dvernooy/ErgWare/docs/ErgWare_info_0.1.pdf

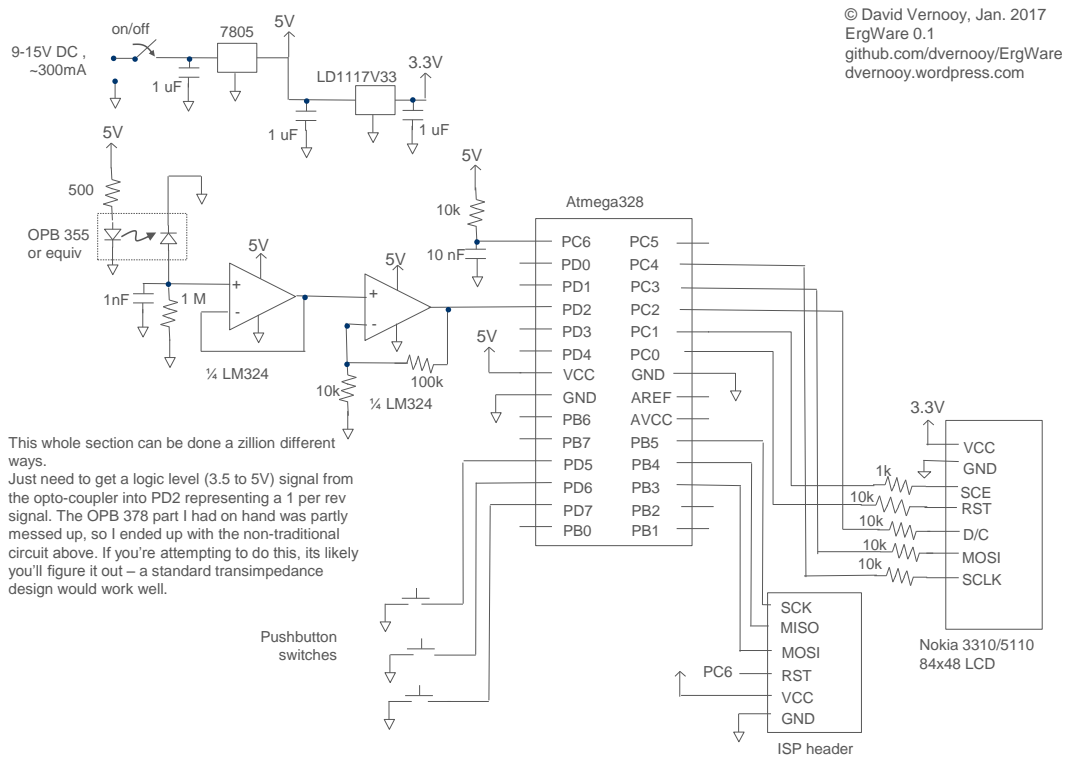
[picture p1: page 1]
Atmega328; PD4 VCC; GND; PC0 GND; AREF; AVCC; Nokia 3310/5110 84x48 LCD; ISP header; SCE RST; MOSI; SCLK; VCC GND; SCK MISO; RST; Pushbutton switches; OPB 355 or equiv; on/off

© David Vernooy, Jan. 2017
ErgWare 0.1
github.com/dvernooy/ErgWare
dvernooy.wordpress.com

This whole section can be done a zillion different
ways.
Just need to get a logic level (3.5 to 5V) signal from
the opto-coupler into PD2 representing a 1 per rev
signal. The OPB 378 part I had on hand was partly
messed up, so I ended up with the non-traditional
circuit above. If you’re attempting to do this, its likely
you’ll figure it out – a standard transimpedance
design would work well.

dvernooy.wordpress.com

Cut out this pattern, Glue or tape to a CD & attach concentric with wheel & slot into slot of optocoupler. Software currently assumes an 8-wedge pattern, but really a single spoke will work with a very minor change to code. I used an old mountain bike wheel and just attached this to where the disk brake would mount on the non-drive/non-cog side.

The OD of this template should fit a standard CD.

The ID should fit the bolt pattern of disk brake. You’ll have to drill a few holes on that radius to mount it & also cut out the center. I used a soldering iron to melt the cd plastic instead of trying to cut it.

You might have to take off the film on the CD to make it transparent, & of course cut away the white paper on this pattern where it goes through the optocoupler

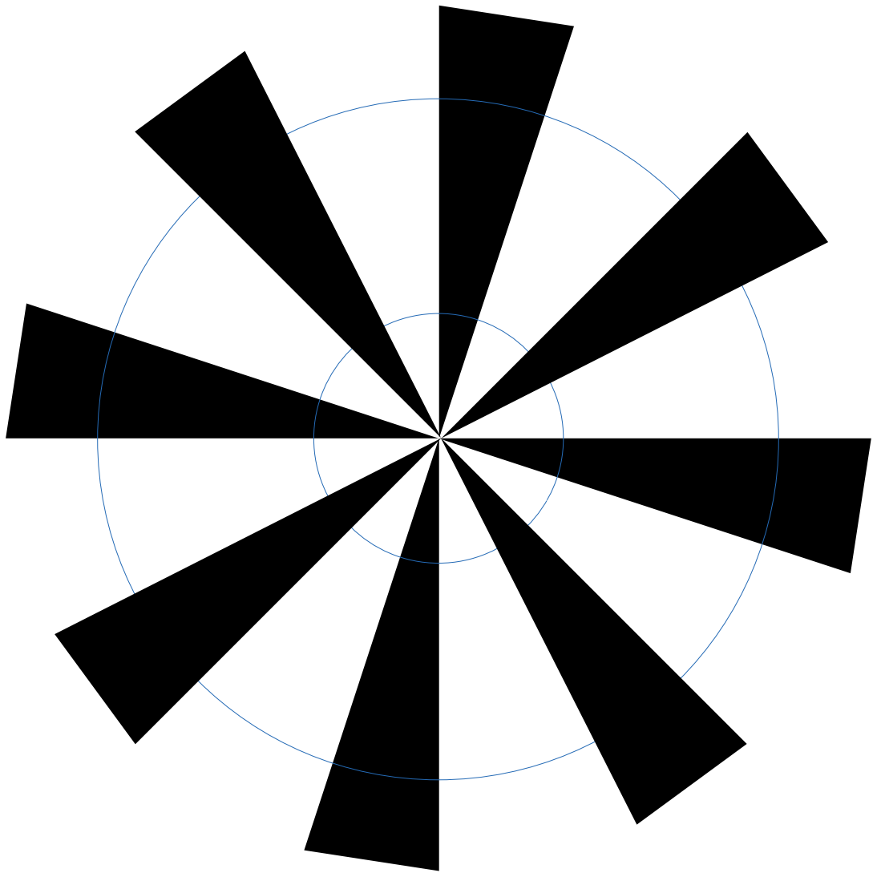
[picture p2: figure]

You could also buy a chopper wheel, use one out of an old optical mouse, or forget this method altogether and just use a reed switch like they typically do in bike computers. In those cases, you’ll probably need to modify the circuit and software.

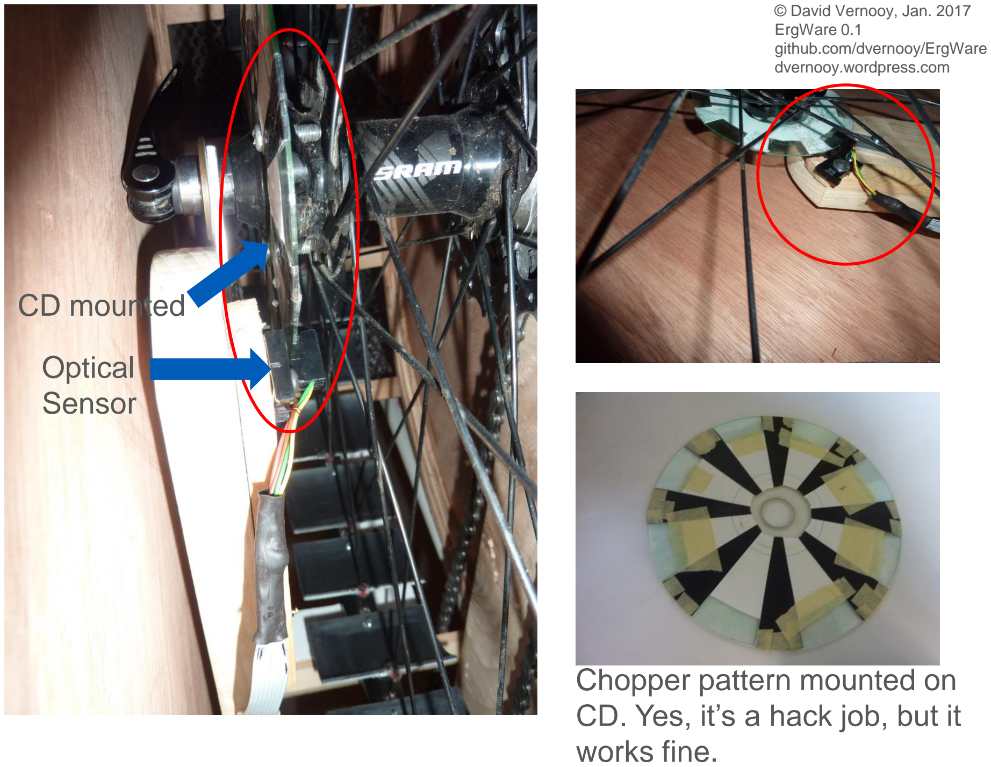
[picture p3: page 3]

dvernooy.wordpress.com

## Optical Sensor

## Chopper pattern mounted on CD. Yes, it’s a hack job, but it

works fine.

## CD mounted

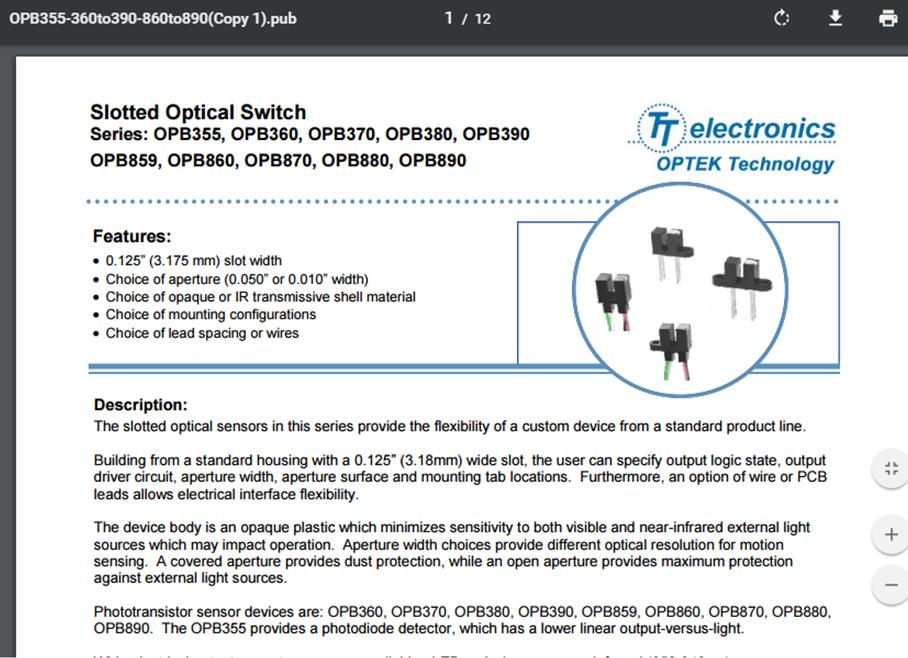
[picture p4: page 4]

dvernooy.wordpress.com

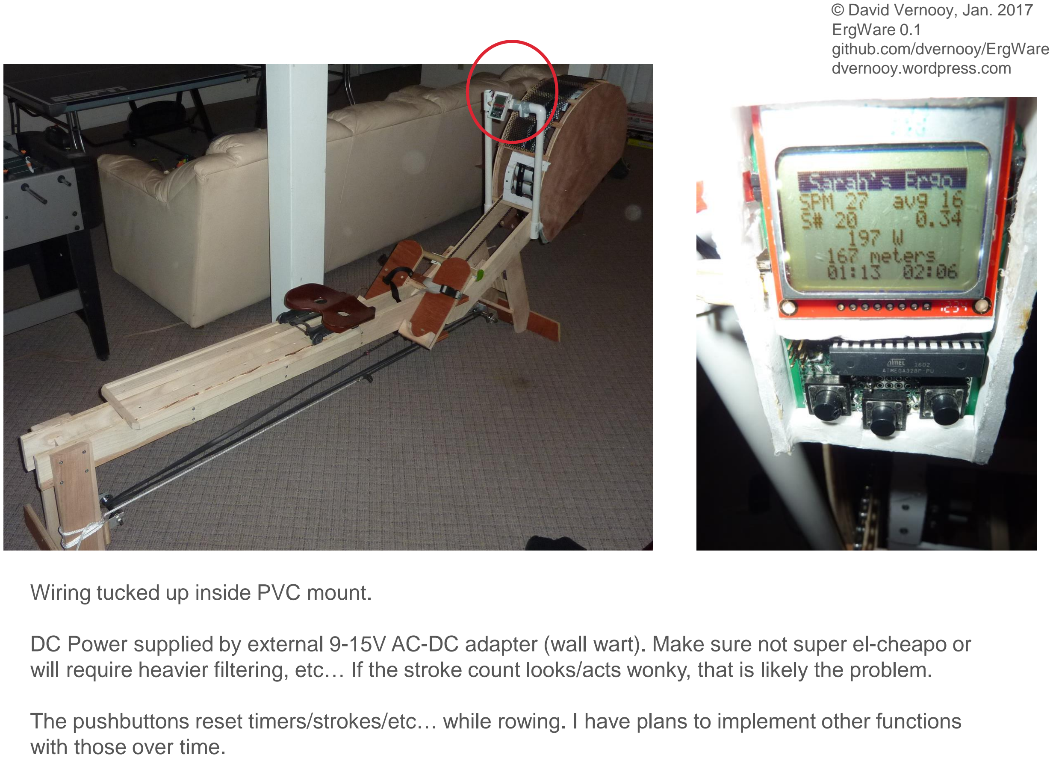
[picture p5: page 5]

dvernooy.wordpress.com

Wiring tucked up inside PVC mount.

DC Power supplied by external 9-15V AC-DC adapter (wall wart). Make sure not super el-cheapo or will require heavier filtering, etc… If the stroke count looks/acts wonky, that is likely the problem.

The pushbuttons reset timers/strokes/etc… while rowing. I have plans to implement other functions with those over time.

dvernooy.wordpress.com

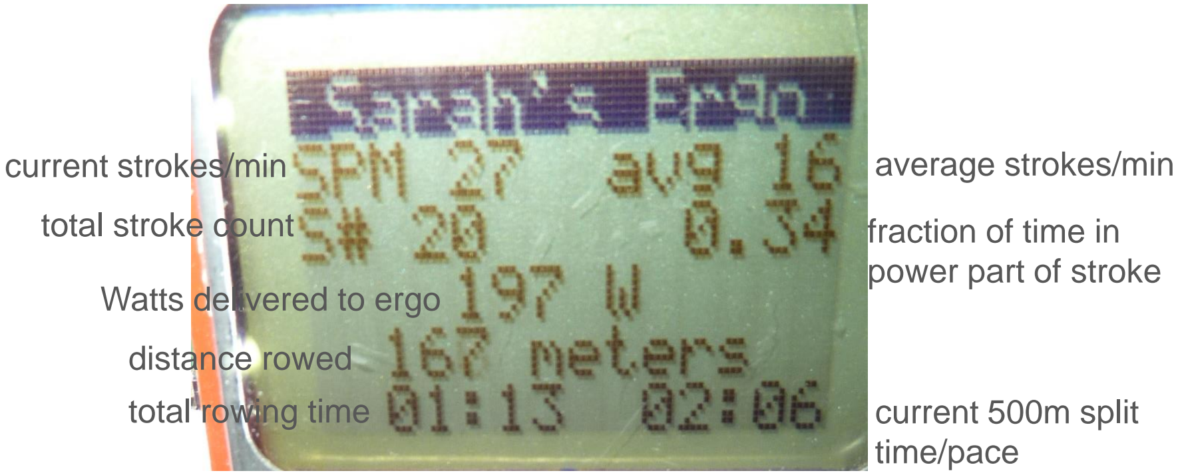
[picture p6: figure]
distance rowed; current strokes/min; average strokes/min; total stroke count; fraction of time in; power part of stroke; Watts delivered to ergo; total rowing time; current 500m split; time/pace
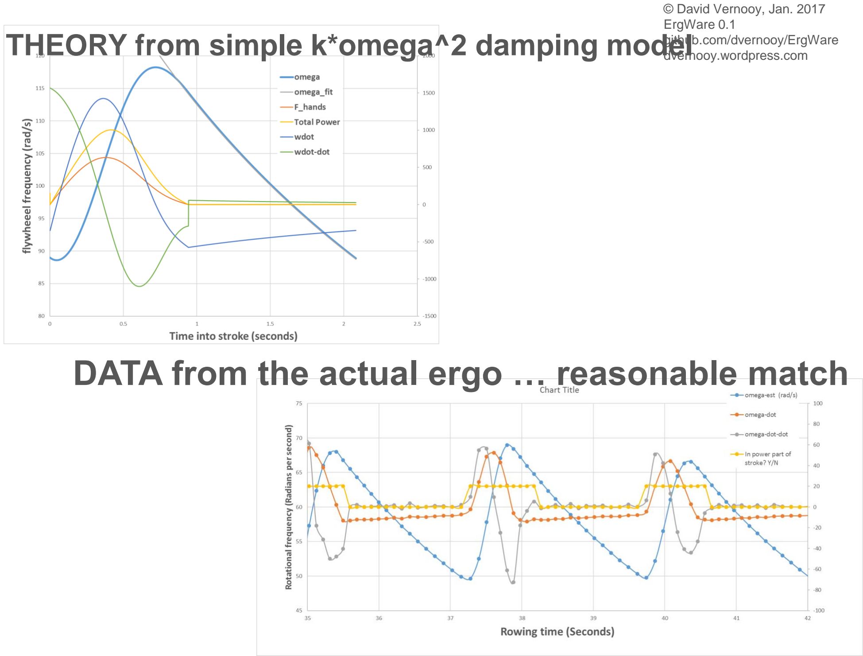
[picture p7: page 7]

github.com/dvernooy/ErgWare THEORY from simple k*omega^2 damping model dvernooy.wordpress.com

# DATA from the actual ergo … reasonable match

dvernooy.wordpress.com

## Good references:

## http://eodg.atm.ox.ac.uk/user/dudhia/rowing/physics/ergometer.html#section9 … for the origin of the factor 2.8 in the code

## http://home.hccnet.nl/m.holst/ErgoDisp.pdf ... Makes me think that at some point displaying energy (calories) burned might be interesting

## http://home.hccnet.nl/m.holst/Ergo.pdf ... Easy to follow model that is the basis for my excel spreadsheet … would be easy to augment the current

software to show the total power the rower is outputting when using the erg ..

## Not just the power actually delivered to the flywheel (which is what I currently show). This would allow the rower to optimize their power delivery to the

flywheel vs. power lost/wasted.

## http://www.analyticcycling.com/WheelsInertia_Page.html … good reference to quickly measure the moment of inertia of your flywheel … required in code
