dvernooy/ErgWare/v0.4/instructions/Beginners_Guide_Luca_Mazzanti.pdf

Guide from beginner to beginner.

This guide is my tribute to great work and support provide me from Dave.

I suggest you to buy same parts ,because a small change could have big differences.
All pieces cost more or less 30/40€ and some hours for your time.

Requirements:

- Arduino uno based on ATMega 328

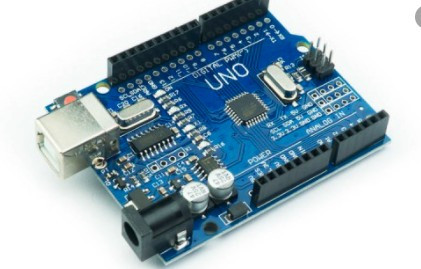
[picture p10: figure]

- LCD Nokia 5110

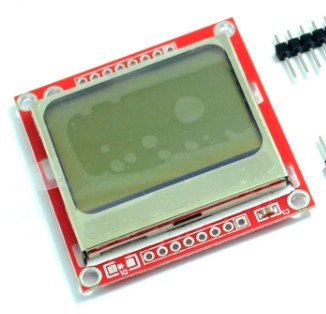
[picture p11: figure]

- Sensor OPB 830 or similar.

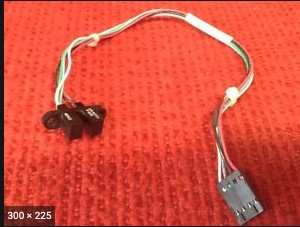
[picture p12: figure]

- 1 kΩ , 270Ω , 4.7 kΩ resistor
- 3 button
- USBASP ISP

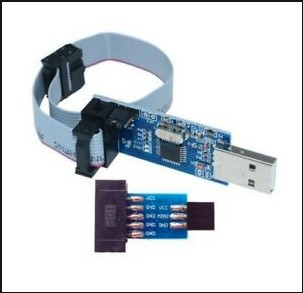
[picture p13: figure]

Software requirements

For windows: zadig. https://zadig.akeo.ie/ is a tools to help you to install usbasp programmator
IMPORTANT use this choice:

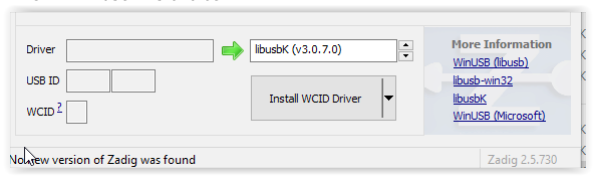
[picture p14: figure]

AVRDUDE http://download.savannah.gnu.org/releases/avrdude/ I used “avrdude-6.2-mingw32.zip”
extract in c:\
and renominate it in avrdude.

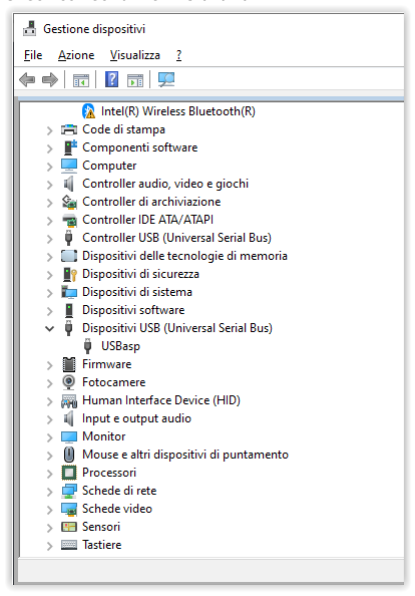
[picture p15: figure]

Check correct driver installation

For Linux and Mac driver shouldn’t be require, you can check with lsbusb. Avrdude is the same and you can find it at same link archive tar.gz or dmg

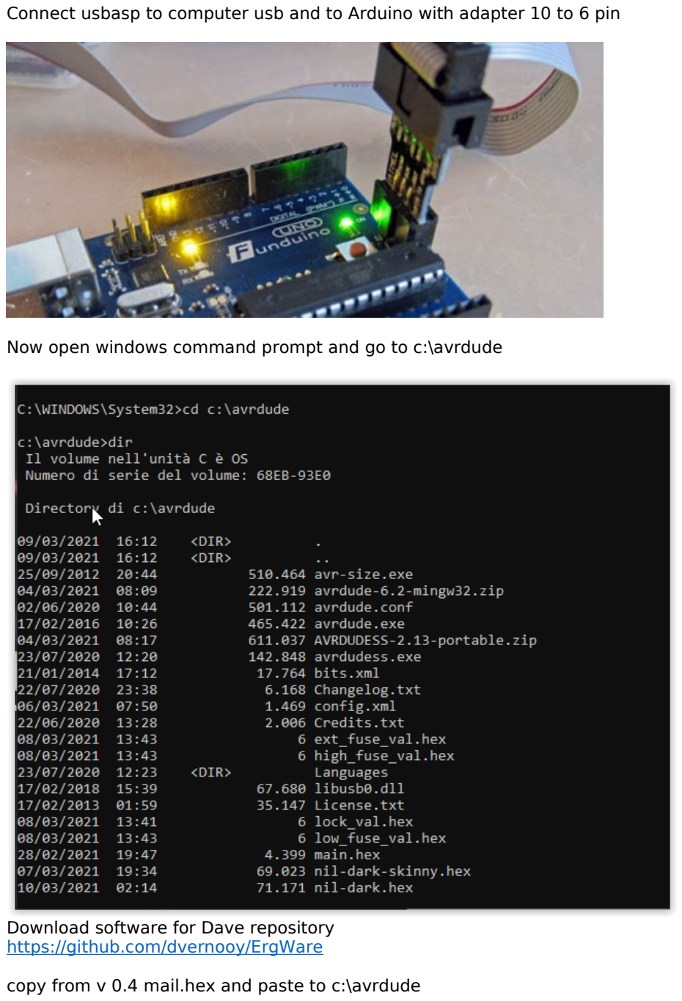
[picture p16: page 4]

Connect usbasp to computer usb and to Arduino with adapter 10 to 6 pin

Now open windows command prompt and go to c:\avrdude

Download software for Dave repository https://github.com/dvernooy/ErgWare

copy from v 0.4 mail.hex and paste to c:\avrdude copy from v 0.4 nil.hex and paste to c:\avrdude

now check if all work
write this command:
avrdude -c usbas-clone p -p m328p -P usb -B 750.0

the result should be something like this:
avrdude: safemode: Fuses OK (E:FD, H:D6, L:FF)

now
avrdude -c usbasp-clone -P usb -p m328p -U lock:r:lock_val.hex:h

output should be something like this
avrdude: safemode: Fuses OK (E:FD, H:D6, L:FF)

Now wire the circuit
Connect LCD pin to arduino.

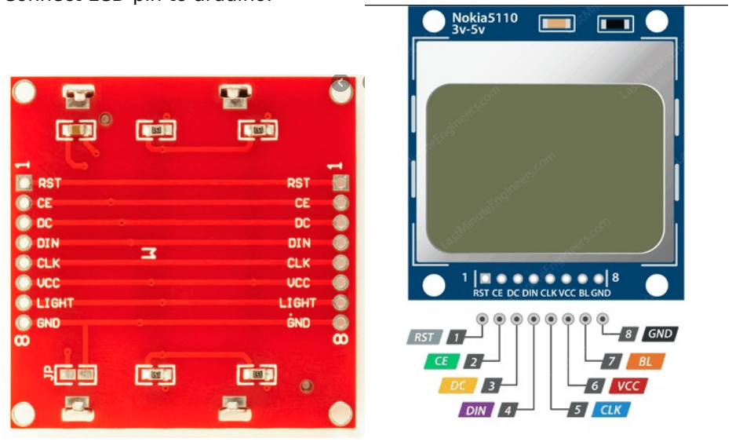
[picture p17: figure]

I buy two LCD one red and one blue, pinout is the same.

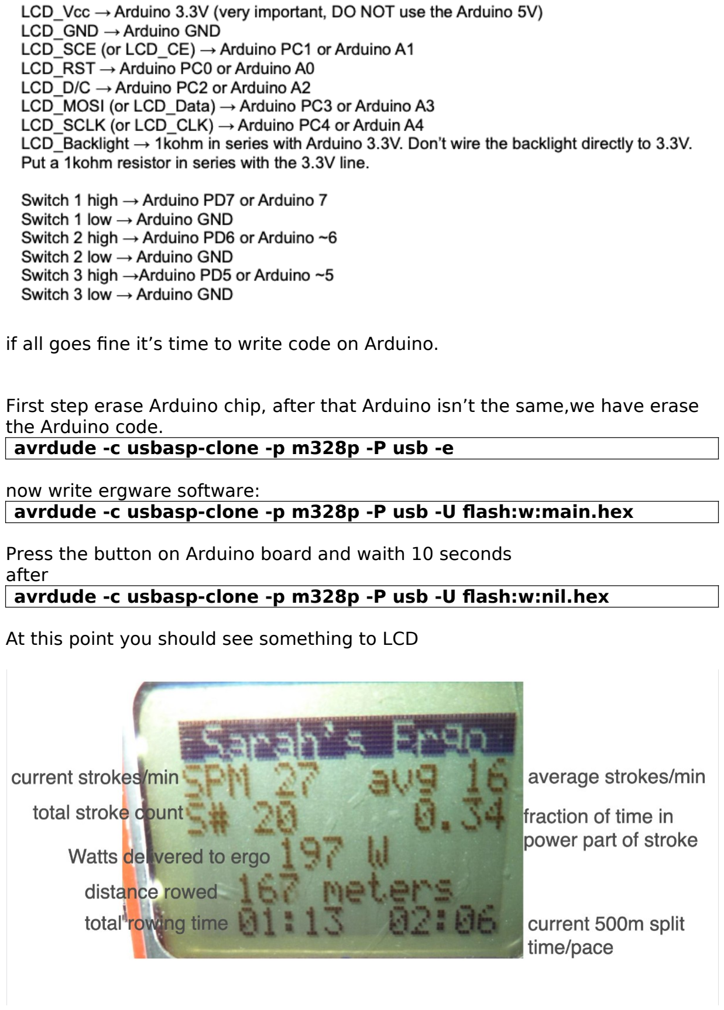
[picture p18: page 6]

if all goes fine it’s time to write code on Arduino.

First step erase Arduino chip, after that Arduino isn’t the same,we have erase the Arduino code.
avrdude -c usbasp-clone -p m328p -P usb -e

now write ergware software:
avrdude -c usbasp-clone -p m328p -P usb -U flash:w:main.hex

Press the button on Arduino board and waith 10 seconds
after
avrdude -c usbasp-clone -p m328p -P usb -U flash:w:nil.hex

At this point you should see something to LCD

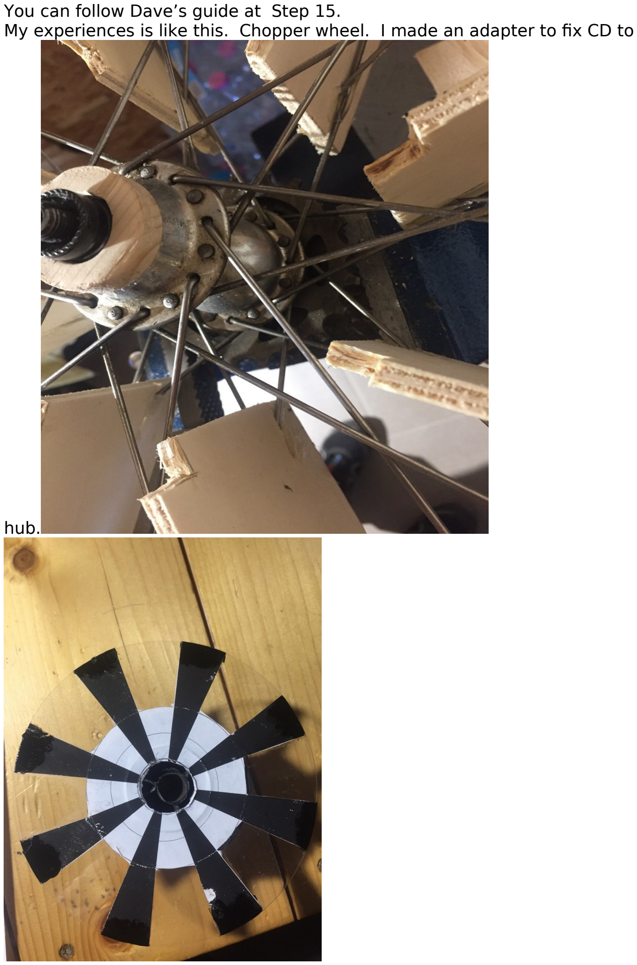
[picture p19: page 7]

You can follow Dave’s guide at Step 15.
My experiences is like this. Chopper wheel. I made an adapter to fix CD to

hub.

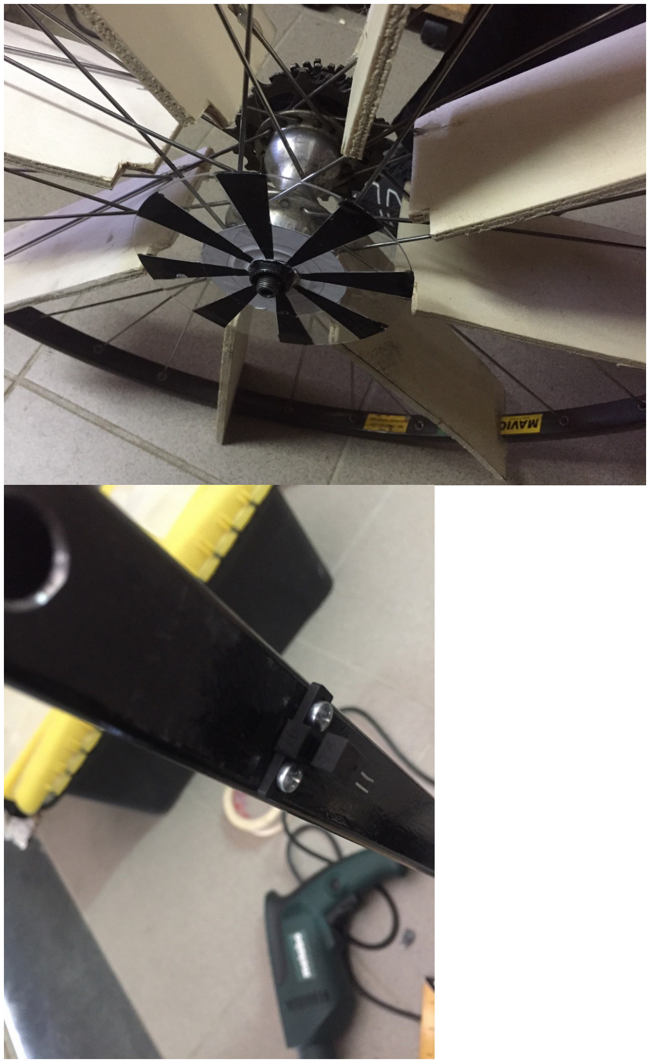
[picture p20: figure]

Now connect the sensor OPB, it has this pinout

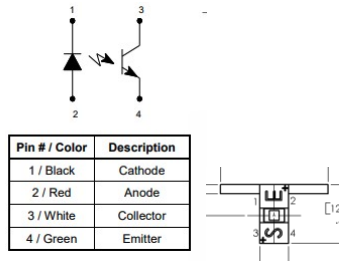
[picture p21: figure]

1 -> GND
2 -> R 270Ω -> 3.3v
3 ->3.3v
4-> R 4.7kΩ -> GND , pin4 to PIN A2 di arduino. (image below)

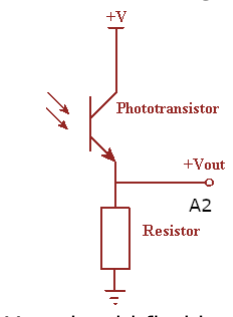
[picture p22: figure]

You should find between A2 and GND 2.9v sensor open(white) , and 0.7v sensor close(black).

At this time you have a splend ergware. Thanks Dave!!

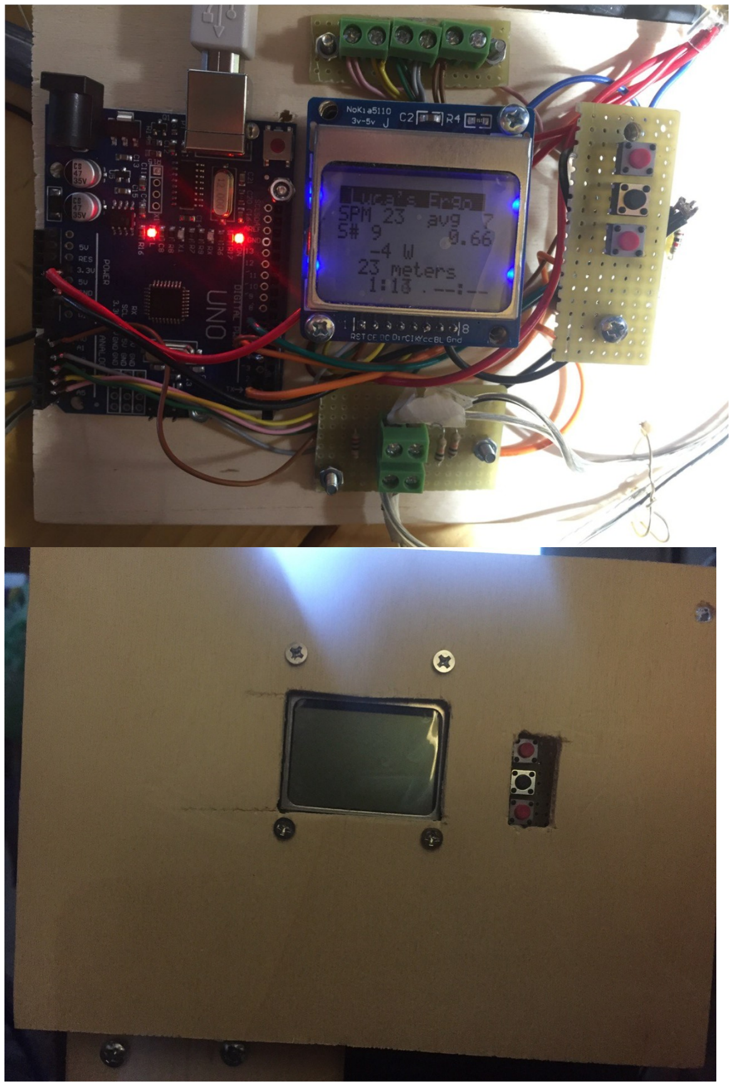
[picture p23: figure]

I attach the links where I buy, only for comparison, choose the best shop for you.
Arduino (https://www.amazon.it/AZDelivery-UNO-R3-ATmega328-compatibile/dp/B01MDJA464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)
LCD (https://www.amazon.it/ICQUANZX-Display-retroilluminazione-Adattatore-Arduino/dp/B07VQ858R2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)
USBASP (https://www.amazon.it/Paradisetronic-com-Dispositivo-Programmazione-Adattatore-Programmatore/dp/B07Y3B8H91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)
OPB 830 (https://www.digikey.com/en/products/detail/tt-electronics-optek-technology/OPB830W55Z/1015250)
