dvernooy/ErgWare/v0.1/v0.11-stroke-debug/erg_model3.xlsx

Sheet: To use this sheet
1. Compile "main.c" from https://github.com/dvernooy/ErgWare/tree/master/v0.1/v0.11-stroke-debug
2. Run the code and row your erg for ~ 20 to 30 strokes.
3. At some point you will see an "asterisk" appear on the screen … this means the EEPROM is filled up. You can stop rowing.
4. Dump the eeprom data to a hex file. With avrdude, it is something like:
avrdude -p m328p -c (programmer) -P (PORT) -b 19200 -U eeprom:r:test.hex:i
on mine I use:
avrdude -p m328p -c avrisp -P /dev/ttyACM0 -b 19200 -U eeprom:r:test.hex:i
5. Open the file "test.hex" you just made & grab the data & paste it into cell A1 of the worksheet "YOUR_data" … it will replace the data in green that is already there
6. Go to the worksheet "YOUR_analysis"
a. set the values in cells O3 and O4 so the power part of the stroke is cleanly identified. You can see a couple of examples for my Erg and Luca's erg. Cell O4 is most important. Move it up and down and you'll see what I mean
b. once you have these values, they will be used in the following variables in the v0.6 code
#define W_DOT_DOT_MIN -20.0
#define W_DOT_DOT_MAX 20.0
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
