dvernooy/ErgWare/v0.1/v0.11-stroke-debug/Luca-moment-of-inertia.xlsx

Sheet: Sheet1
 |  | # | m | M | r | J |  | x | y | z | h | H | rho (density) | mass estimate
 |  | number | mass each | total mass | radius | moment each element |  |  |  |  |  |  | plywood density, from web) | Dave's estimate, compare to Luca's 60g
 | Luca info |  | grams | grams | meters |  | formula | meters | meters | meters | meters | meters | kg/m^3 | grams
dampers | 8x24*0.5cm | 8 | 60 | 480 |  | 0.0180 | 1/12*M*(y^2+z^2)+M*H^2 | 0.08 | 0.24 | 0.005 | 0.061 | 0.181 | 680 | 65.28
rim | mavic ma40 | 1 | 480 | 480 | 0.311 | 0.0464 | M*r^2 |  |  |  |  |  |  | ok!!!!
spokes |  | 32 | 8 | 256 | 0.311 | 0.0083 | 1/3M*r^2
nipples |  | 32 | 2 | 64 | 0.311 | 0.0062 | M*r^2
cassette | 10 speed? | 10 | 27.5 | 275 | 0.06 | 0.0005 | 1/2M*r^2
hub | campy | 1 | 300 | 300 | 0.04 | 0.0005 | M*r^2
 |  |  |  |  | total | 0.07987502933 | kg*m^2
 | Dave | Luca-old | Luca-new
J (moment of inertia) | 0.16 | 0.16 | 0.0799
d_omega_div_omega^2 (K_D) | 0.0031 | 0.0031 | 0.0405
K_damp | 0.0005 | 0.0005 | 0.0032
d_omega_div_omega^2-est (K_D est) … while rowing | 0.0031 | 0.0171 | 0.0405 | .04350 to .03750 (from Luca, so take average)
inferred K_damp | 0.0005 | 0.0027 | 0.0032
cal factor | 0.1764375781 |  | 0.3296839436
 | 0.3528751562 |  | 0.6593678871 | 1.868558541

Sheet: Sheet1 (2)
 |  | # | m | M | r | J |  | x | y | z | h | H | rho (density) | mass estimate
 |  | number | mass each | total mass | radius | moment each element |  |  |  |  |  |  | plywood density, from web) | Dave's estimate, compare to Luca's 60g
 | Luca info |  | grams | grams | meters |  | formula | meters | meters | meters | meters | meters | kg/m^3 | grams
dampers | 8x24*0.5cm | 8 | 60 | 480 |  | 0.0180 | 1/12*M*(y^2+z^2)+M*H^2 | 0.08 | 0.24 | 0.005 | 0.061 | 0.181 | 680 | 65.28
rim | mavic ma40 | 1 | 480 | 480 | 0.311 | 0.0464 | M*r^2 |  |  |  |  |  |  | ok!!!!
spokes |  | 32 | 8 | 256 | 0.311 | 0.0083 | 1/3M*r^2
nipples |  | 32 | 2 | 64 | 0.311 | 0.0062 | M*r^2
cassette | 10 speed? | 10 | 27.5 | 275 | 0.06 | 0.0005 | 1/2M*r^2
hub | campy | 1 | 300 | 300 | 0.04 | 0.0005 | M*r^2
 |  |  |  |  | total | 0.07987502933 | kg*m^2
 | Dave | Luca-old | Luca-new
J (moment of inertia) | 0.16 | 0.16 | 0.0799
d_omega_div_omega^2 (K_D) | 0.0027 | 0.0031 | 0.0140 | .0170 to .02210 (from Luca, so take average)
K_damp | 0.0004 | 0.0005 | 0.0011
d_omega_div_omega^2-est (K_D est) … while rowing | 0.0027 | 0.0171 | 0.0140
inferred K_damp | 0.0004 | 0.0027 | 0.0011 | 2.5894
cal factor | 0.1684968467 |  | 0.2313780379
 | 0.3369936935 |  | 0.4627560758 | 1.373189127
