dvernooy/ErgWare/(threads)

Thread 1 (2019-03-31):

arduino

skraburski, 2019-03-31:
Hi Dave,
I absolutelt love your project, kudos for that!!!

I've spare arduino uno smd at home and was thinking on using it as it is using ATmega328 as you did in your project but I could spare time on designing hardware. I would just need to connect display, sensor and buttons and it would be ready.

Did you ever think of that or maybe have ready version of your soft that I could put on arduino?

Regards
Lukasz

dvernooy, 2021-02-07:
Hi Lukasz, there are a couple of options for Arduino compatibility.

Option 1 is to use your Arduino Uno hardware board, but not the Arduino bootloader. In this case, you would program the board directly from something like Atmel studio, or whatever environment you want that uses avr-gcc & avrdude. There are several tutorials on-line about how to do this. You might have to change the clock fuse settings & a few lines of code to map ports (for the buttons, sensor and disply) depending on which of the '328 ports the Uno makes available. I have not looked into it, but I think I have an Uno lying around at home and can help with this if you are really serious about it. It also means you would have to re-install the bootloader if you ever wanted to re-use the Uno because Option 1 would over-write it. This may sound difficult, but I think it is actually really very simple.

Option 2 is to make an Arduino wrapper for the code. That could be quite a bit more involved given the use of the RTOS in the latest version. There are a couple of Arduino versions of the RTOS on-line that could be used, but I definitely have not studied them. My feeling is this method is (way) more involved that Option 1 ... but I understand it could be more satisfying to many people because it would use the Arduino environment they are used to. But again, if you are really serious about going down this route it I'd be happy to help out.

Let me know if this is still something you are thinking about.

-Dave

Closed 2021-02-07.

Thread 2 (2020-09-02):

Using your code

wilburforce83, 2020-09-02:
Hi there,

I was wondering if you would mind me using your base code (calculations / assumptions etc) in order to build a nodeJS application for a raspberry pi; I am looking at trying to create an easily replicable unit for myself and others to add to their openergos.

My plan is to build a nice looking GUI front end, with similar sensors connecting to the GPIO's then use your equations to generate the data feeds in a front end, with perhaps a syncing method to Garmin connect or something.

I will of course credit you for doing all the hard work!

dvernooy, 2021-02-07:
Hi - of course this would be fine! (Its the whole point of open source). I know the project I have posted is not super easy to replicate & a raspberry pi or arduino-based solution might be easier. Let me know how I can help - I'm more than willing to pitch in if you run into any issues.

-Dave

Closed 2021-02-07.
