dvernooy/ErgWare/v0.6/Arduino_Uno_version/eeprom_burn/eeprom_burn.ino

/*
** main.c
**
*/
#include <avr/eeprom.h>
#include <inttypes.h>
#include <avr/io.h>


/* Alphabet lookup */
unsigned char font5x7 [][5] = {
	{ 0x00, 0x00, 0x00, 0x00, 0x00 },   // sp - 0
    { 0x00, 0x00, 0x2f, 0x00, 0x00 },   // !
    { 0x00, 0x07, 0x00, 0x07, 0x00 },   // "
    { 0x14, 0x7f, 0x14, 0x7f, 0x14 },   // #
    { 0x24, 0x2a, 0x7f, 0x2a, 0x12 },   // $
	{ 0x32, 0x34, 0x08, 0x16, 0x26 },   // %
    { 0x36, 0x49, 0x55, 0x22, 0x50 },   // &
    { 0x00, 0x05, 0x03, 0x00, 0x00 },   // '
    { 0x00, 0x1c, 0x22, 0x41, 0x00 },   // (
    { 0x00, 0x41, 0x22, 0x1c, 0x00 },   // )
    { 0x14, 0x08, 0x3E, 0x08, 0x14 },   // *
    { 0x08, 0x08, 0x3E, 0x08, 0x08 },   // +
    { 0x00, 0x00, 0x50, 0x30, 0x00 },   // ,
    { 0x10, 0x10, 0x10, 0x10, 0x10 },   // -
    { 0x00, 0x60, 0x60, 0x00, 0x00 },   // .
    { 0x20, 0x10, 0x08, 0x04, 0x02 },   // /-15
    { 0x3E, 0x51, 0x49, 0x45, 0x3E },   // 0
    { 0x00, 0x42, 0x7F, 0x40, 0x00 },   // 1
    { 0x42, 0x61, 0x51, 0x49, 0x46 },   // 2
    { 0x21, 0x41, 0x45, 0x4B, 0x31 },   // 3
    { 0x18, 0x14, 0x12, 0x7F, 0x10 },   // 4
    { 0x27, 0x45, 0x45, 0x45, 0x39 },   // 5
    { 0x3C, 0x4A, 0x49, 0x49, 0x30 },   // 6
    { 0x01, 0x71, 0x09, 0x05, 0x03 },   // 7
    { 0x36, 0x49, 0x49, 0x49, 0x36 },   // 8
    { 0x06, 0x49, 0x49, 0x29, 0x1E },   // 9
    { 0x00, 0x36, 0x36, 0x00, 0x00 },   // :
    { 0x00, 0x56, 0x36, 0x00, 0x00 },   // ;
    { 0x08, 0x14, 0x22, 0x41, 0x00 },   // <
    { 0x14, 0x14, 0x14, 0x14, 0x14 },   // =
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
			addr = 631 + (i*11+j+1);
			eeprom_update_byte((uint8_t *) addr , ByteOfData);
        }
	}
	
		    for(i=0;i<3;i++) {
		    for(j=0;j<60;j++) {
			ByteOfData = Paddle[i][j];
			addr = 807 + (i*60+j+1);
			eeprom_update_byte((uint8_t *) addr , ByteOfData);
        }
	}

}
