dvernooy/ErgWare/v0.6/Arduino_Uno_version/main/time.cpp

/*

Copyright (C) David W. Vernooy

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
You should have received a copy of the GNU General Public License
along with this program; if not, write to the Free Software
Foundation, Inc., 51 Franklin Street, Fifth Floor, Boston, MA  02110-1301, USA.
*/


#include "time.h"

#define ST2MS(n) ((n) * 1000UL/NIL_CFG_ST_FREQUENCY)

static uint32_t volatile Seconds=0;
static uint16_t volatile MilliSeconds=0;
static systime_t volatile System_time, System_delta;

void TimeInit(void)
{
	System_time = chVTGetSystemTimeX();	 
}


/*
 * Support thread.
 */
THD_WORKING_AREA(waTimer, 15);
THD_FUNCTION(timer, arg) {
  (void) arg;
  /* Initializing global resources.*/
  TimeInit();

  /* Waiting for button push and activation of the test suite.*/
  while (true) {
  chSysLock(); 
  System_delta = chVTTimeElapsedSinceX(System_time);	
  System_time = chVTGetSystemTimeX();	 
  chSysUnlock(); 

  MilliSeconds+=ST2MS(System_delta);
	if (MilliSeconds>=999)
	{
		Seconds++;
		MilliSeconds=0;
		minute_counter = (double) Seconds/60.0;
	}
	chThdSleepMilliseconds(20);
  }
}

void GetTime(TIME *ptr)
{
	//disable the Timer ISR 	
	//TIMSK0=TIMSK0 & ~(1<<OCIE0A); //Timer0 compare A interrupt OFF
	chSysLock(); 
	//set the time
	ptr->milliseconds_time=MilliSeconds;
	ptr->seconds_time=Seconds;
	
	//enable ISR
	//TIMSK0=TIMSK0 | (1<<OCIE0A); //Timer0 compare A interrupt ON
	chSysUnlock(); 

}

uint32_t Get_elapsed_ms(TIME *pStart)
{
	uint32_t temp;
	TIME t;
	GetTime(&t);

	temp=(t.seconds_time-pStart->seconds_time)*1000;
  	temp=temp + t.milliseconds_time;
  	temp=temp-pStart->milliseconds_time;
	return temp;
}

uint32_t Get_elapsed_s(TIME *pStart)
{
	uint32_t temp;
	TIME t;
	GetTime(&t);
	temp=(t.seconds_time-pStart->seconds_time);
 	return temp;
}

uint32_t getSeconds(void)
{
	uint32_t temp;
	//TIMSK0=TIMSK0 & ~(1<<OCIE0A); //Timer0 compare A interrupt OFF
	chSysLock(); 
	//set the time variables
	temp=Seconds;
	//turn ISR back on
	//TIMSK0=TIMSK0 | (1<<OCIE0A); //Timer0 compare A interrupt ON
	chSysUnlock();
	return temp;
}
