dvernooy/ErgWare/(commit log)

2017-01-14 all the subfolders
    [ErgWare_model_0.1.xlsx]
2018-01-12 v0.2 commit
    [bigfont.xls, large_font.xls]
2021-02-14 added v0.3
    [bigfont.xls, large_font.xls]
2021-02-16 simplified rtos
    [bigfont.xls, large_font.xls]
2021-02-17 button algorithm
    [bigfont.xls, large_font.xls]
2021-03-10 fixed right button
2021-03-27 custom versions
    [Luca-moment-of-inertia.xlsx]
2021-03-30 fix power
2021-04-02 update algorithm
    [Luca-moment-of-inertia.xlsx, erg_model2.xlsx]
