dvernooy/ErgWare/(notices)

Notices in the files:
v0.6/Arduino_Uno_version/main/main.ino:
modify it under the terms of the GNU General Public License
v0.6/Standard_version/source/os/nilcore.h:
ChibiOS/NIL is free software; you can redistribute it and/or modify
it under the terms of the GNU General Public License as published by
the Free Software Foundation; either version 3 of the License, or
(at your option) any later version.
